nakulramji/Nakul_Ramji_HackerFabIITB_Submission/drawings/drawing1_plate.png

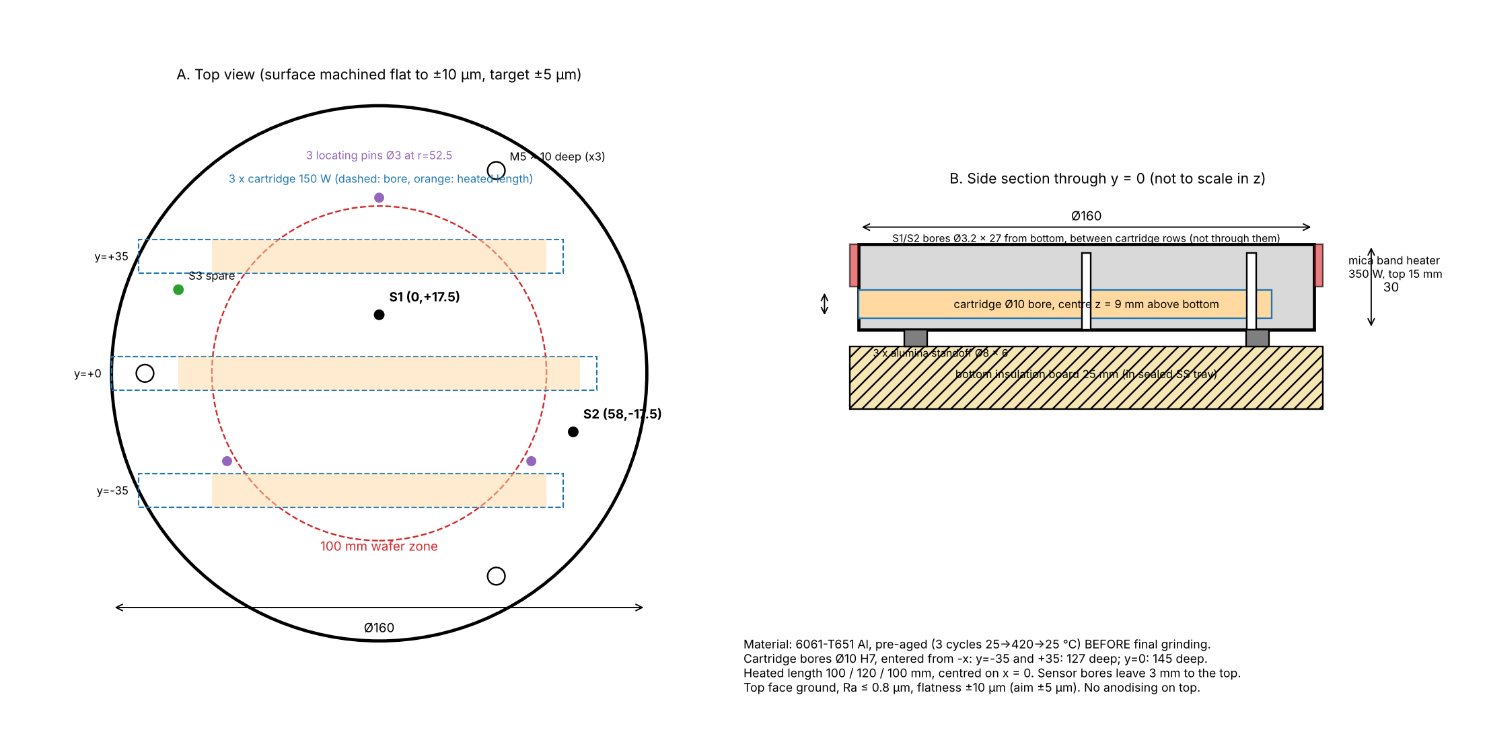
drawings/drawing1_plate.png
