nakulramji/Nakul_Ramji_HackerFabIITB_Submission/figures/fig1_uniformity_map_400C.png

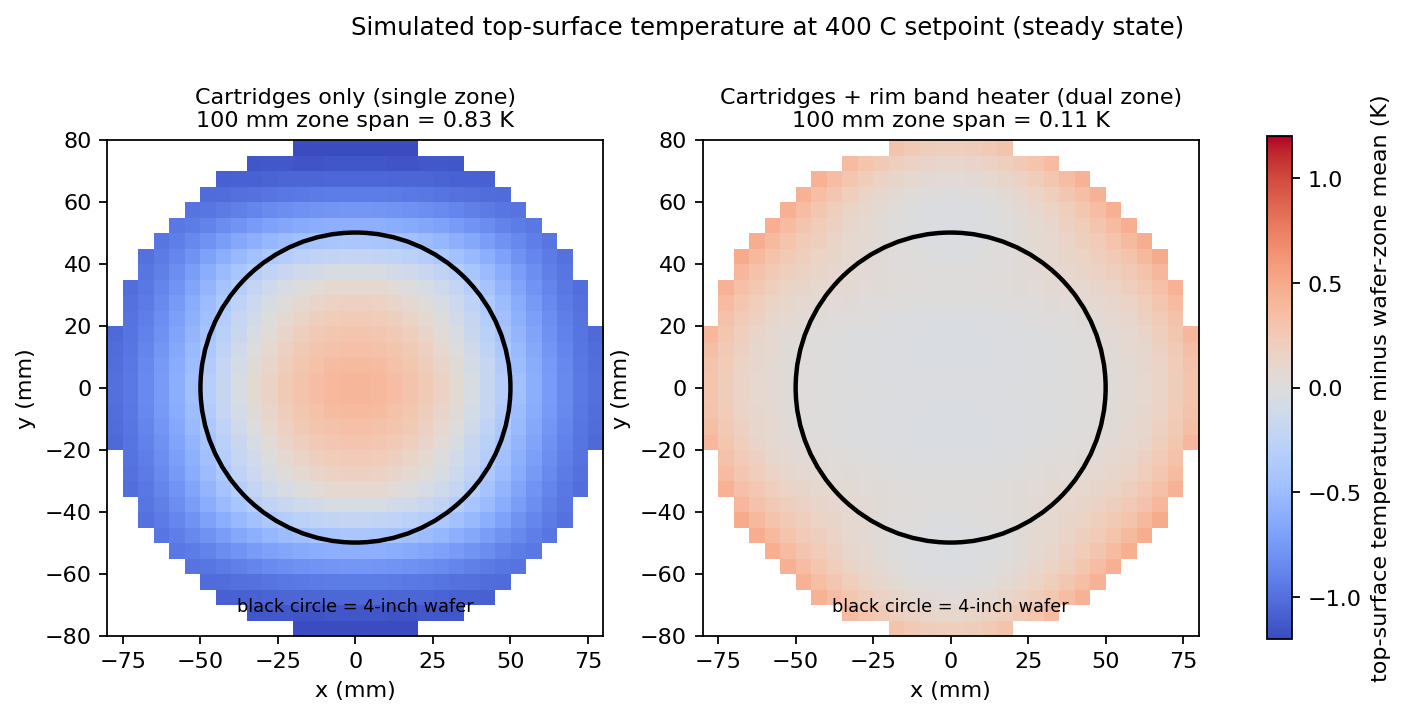
figures/fig1_uniformity_map_400C.png
