nakulramji/Nakul_Ramji_HackerFabIITB_Submission/figures/fig2_span_vs_setpoint.png

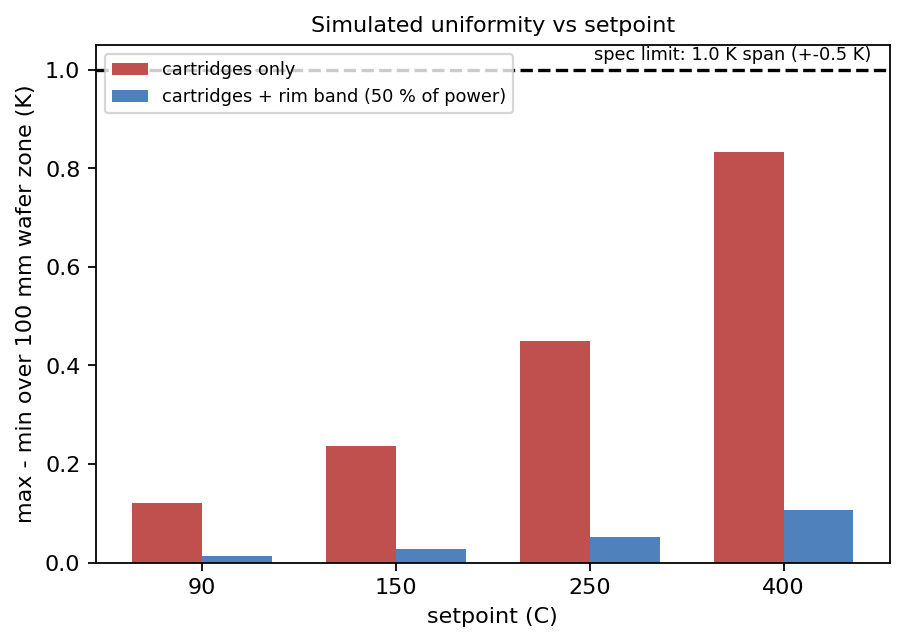
figures/fig2_span_vs_setpoint.png
