nakulramji/Nakul_Ramji_HackerFabIITB_Submission/figures/fig3_cross_section_400C.png

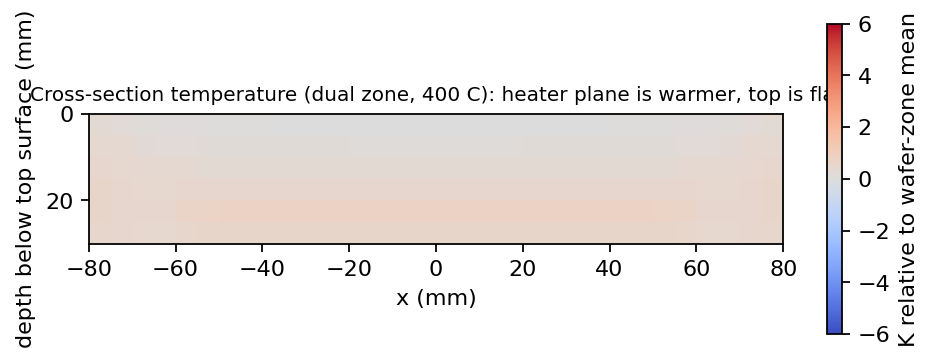
figures/fig3_cross_section_400C.png
