nakulramji/Nakul_Ramji_HackerFabIITB_Submission/figures/fig4_control_runs.png

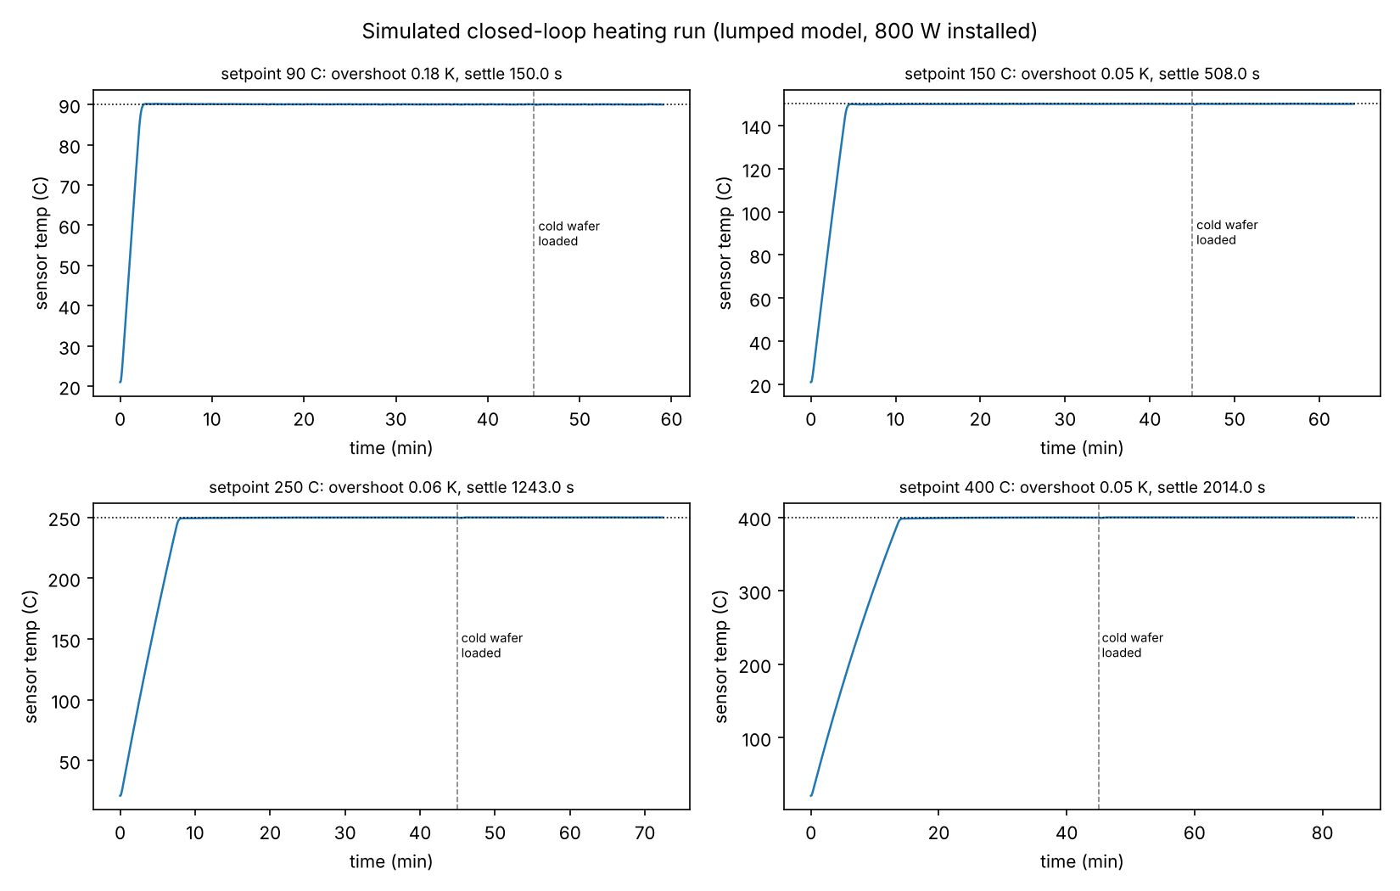
figures/fig4_control_runs.png
