nakulramji/Nakul_Ramji_HackerFabIITB_Submission/drawings/drawing2_assembly.png

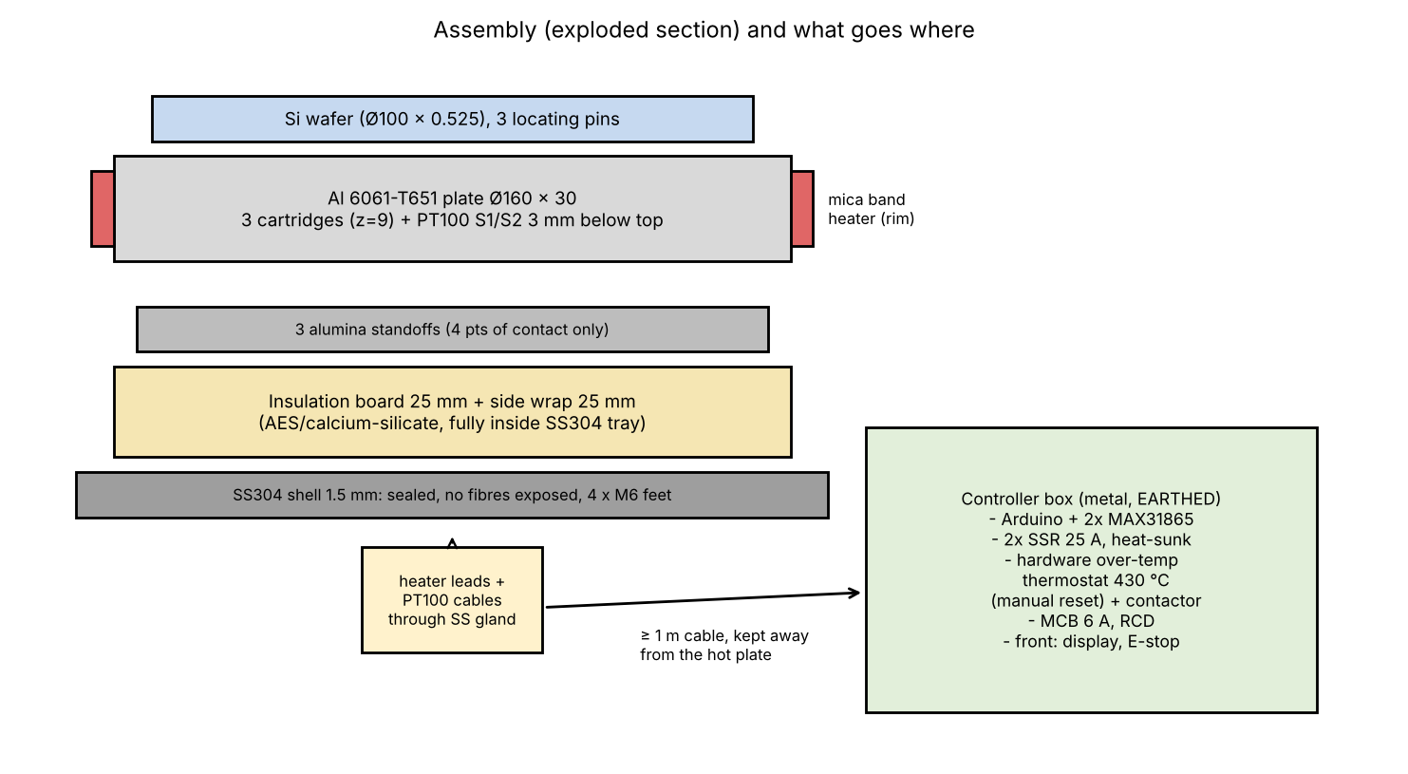
drawings/drawing2_assembly.png
