nakulramji/Nakul_Ramji_HackerFabIITB_Submission/drawings/drawing3_wiring.png

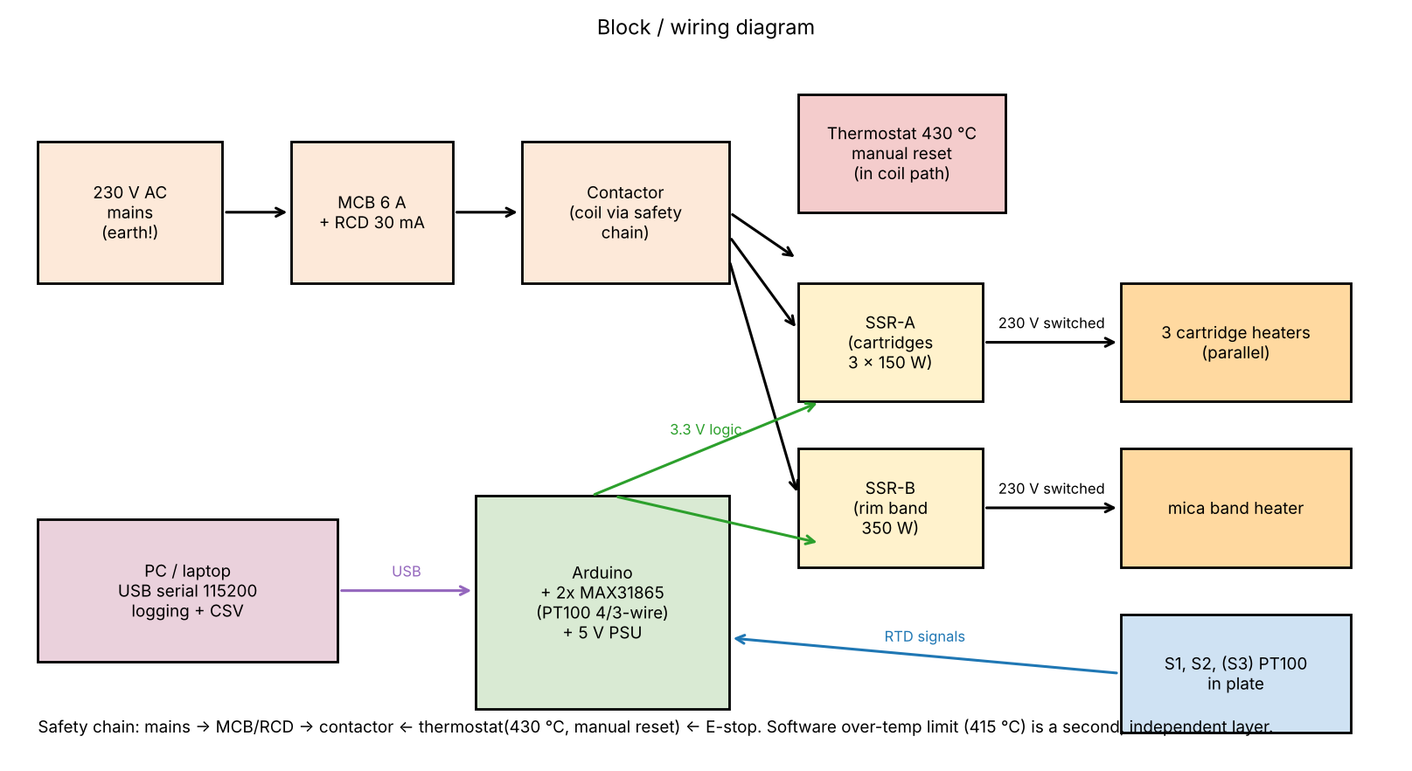
drawings/drawing3_wiring.png
